marieblasi/wro2024-robotek/models/parts/gear.jpeg

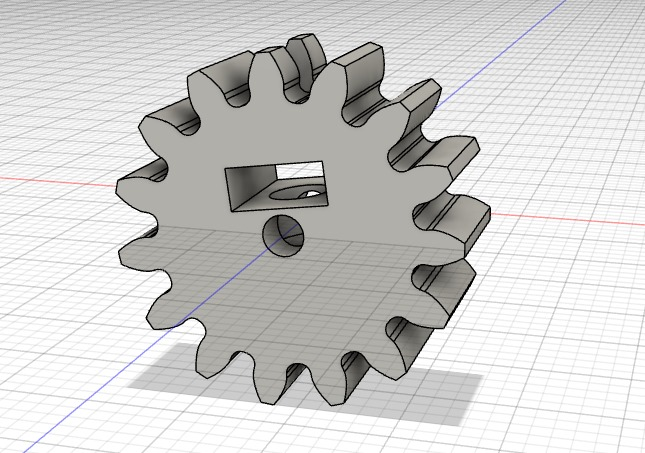
models/parts/gear.jpeg
