marieblasi/wro2024-robotek/models/parts/gear2.jpeg

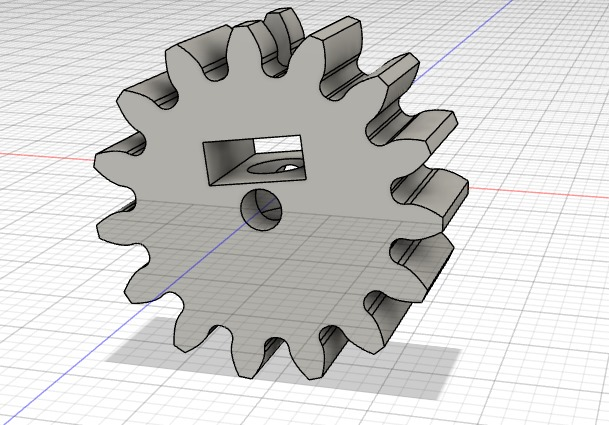
models/parts/gear2.jpeg
