marieblasi/wro2024-robotek/models/README.md

__3D-Printed Models__
====
An important factor in our project was the creation of 3D-printed models specifically designed to securely hold sensors and mechanical parts in place. These custom designs provided precise alignment and reduced potential obstructions. Furthermore, we employed 3D printing to fabricate durable yet lightweight structural elements, enabling us to customize the vehicle's design to meet our requirements without compromising on strength or flexibility.

In the [assemblies](assemblies) folder, there are the images of some systems.
In the [parts](parts) folder, there are images of all the parts we used for the car.
