marieblasi/wro2024-robotek/schemes/README.md

Electromechanical diagrams
====
Our full schematic diagram  to map meticulously the integration of every single component, the electromagnetic elements included. This diagram enssures precise conexions and fluid interactions between the circuits and the electromagnetic devices, like engines and sensors. Also, our flowdiagram is added to provide extra information related to our solution for the challenge.
