marieblasi/wro2024-robotek/models/back_3d.jpeg

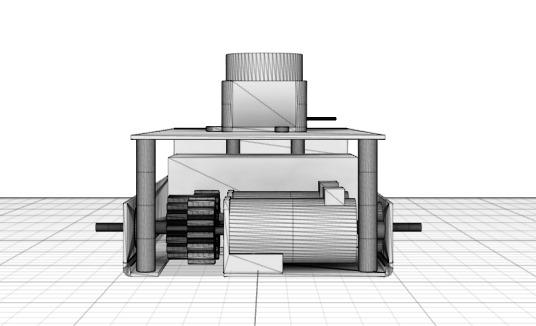
models/back_3d.jpeg
