marieblasi/wro2024-robotek/models/bottom_3d.jpeg

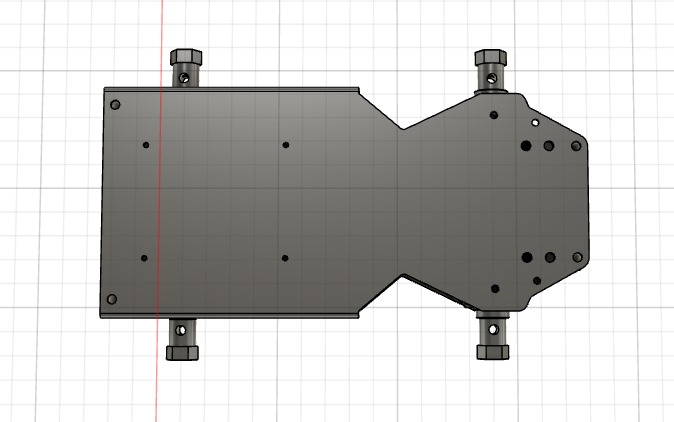
models/bottom_3d.jpeg
