marieblasi/wro2024-robotek/models/front_3d.jpeg

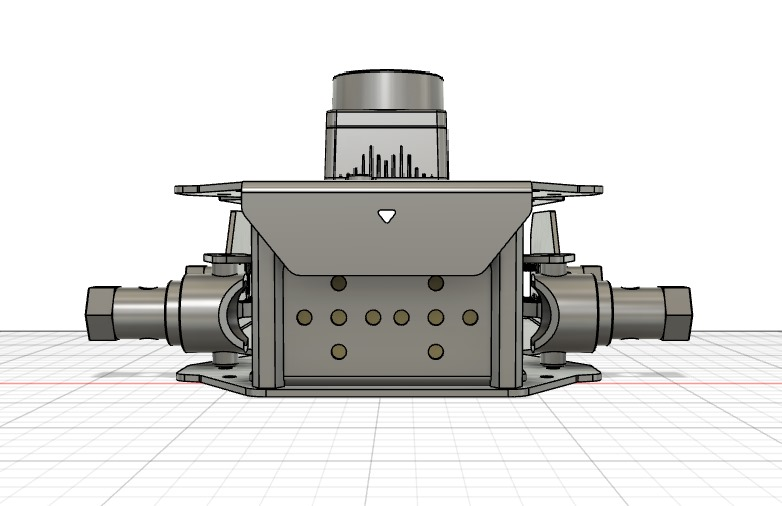
models/front_3d.jpeg
