marieblasi/wro2024-robotek/models/left_3d.jpeg

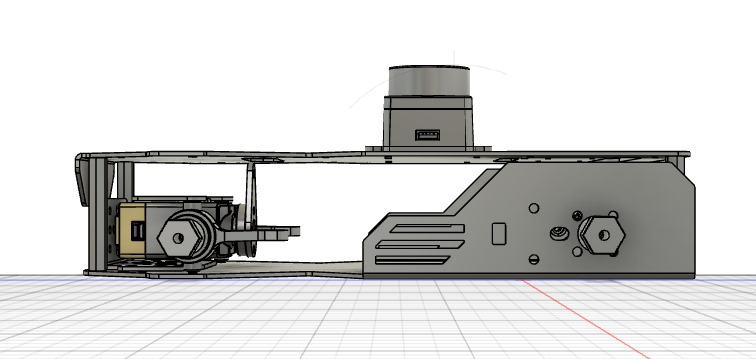
models/left_3d.jpeg
