marieblasi/wro2024-robotek/models/right_3d.jpeg

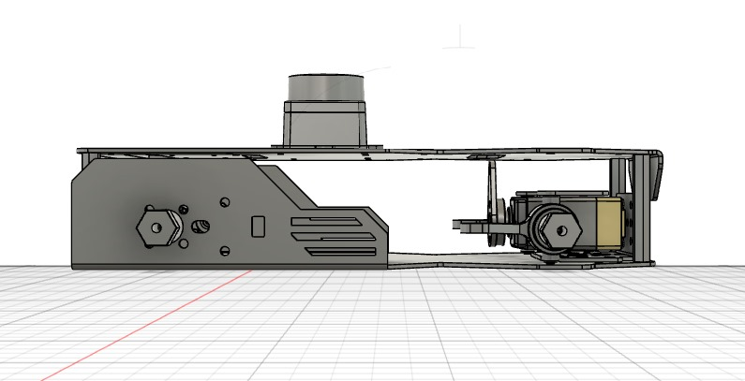
models/right_3d.jpeg
