marieblasi/wro2024-robotek/models/top_3d.jpeg

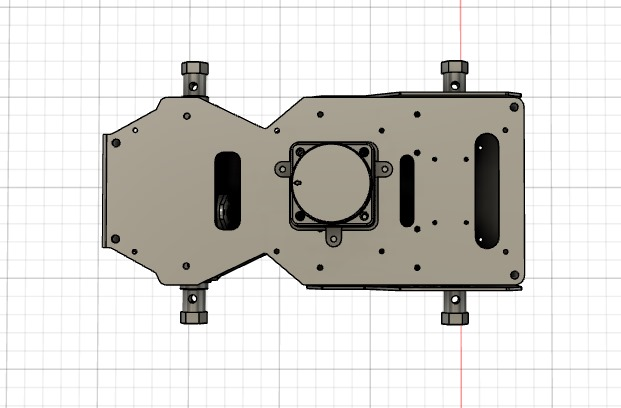
models/top_3d.jpeg
