marieblasi/wro2024-robotek/schemes/flow_diagram_obstacle_challenge.jpeg

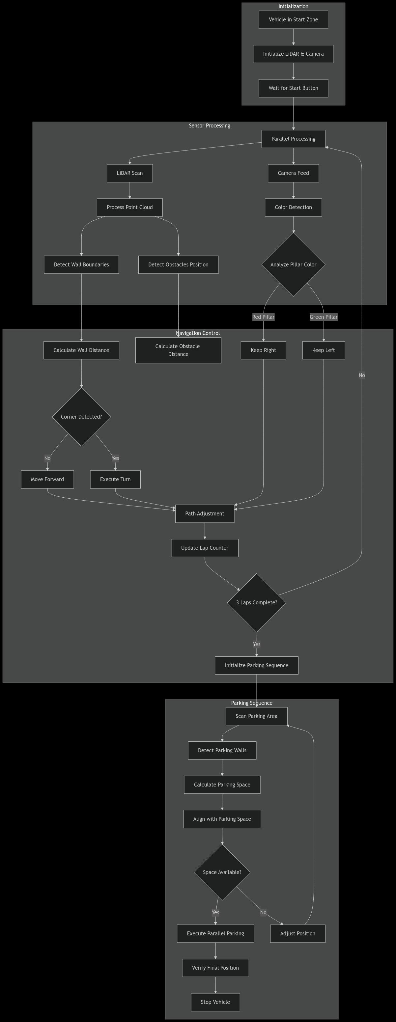
schemes/flow_diagram_obstacle_challenge.jpeg
