marieblasi/wro2024-robotek/schemes/flow_diagram_open_challenge.jpeg

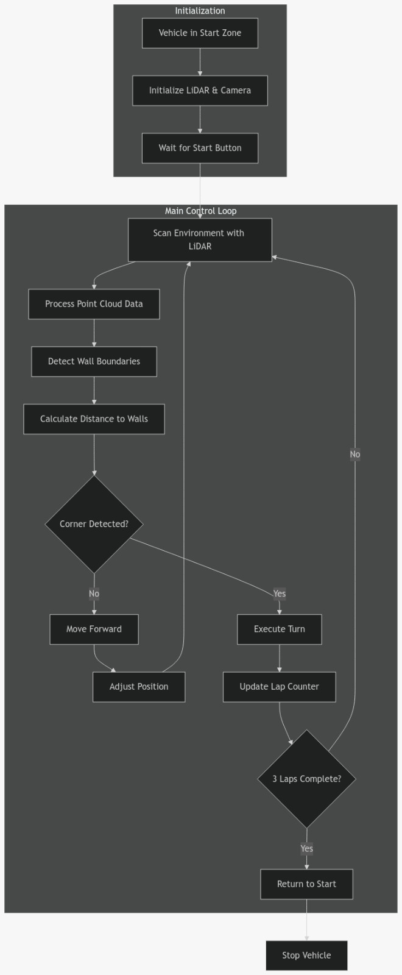
schemes/flow_diagram_open_challenge.jpeg
