marieblasi/wro2024-robotek/t-photos/funny photo.jpg

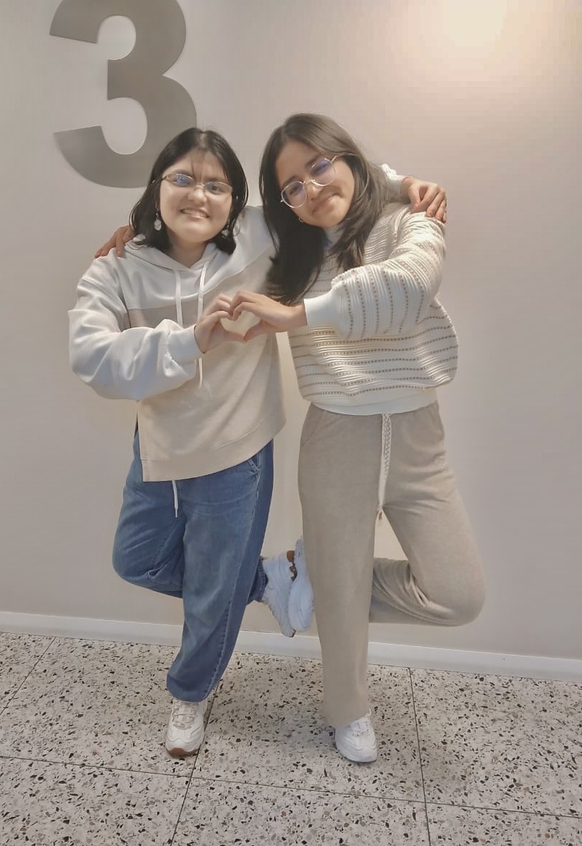
t-photos/funny photo.jpg
