marieblasi/wro2024-robotek/t-photos/official photo.jpg

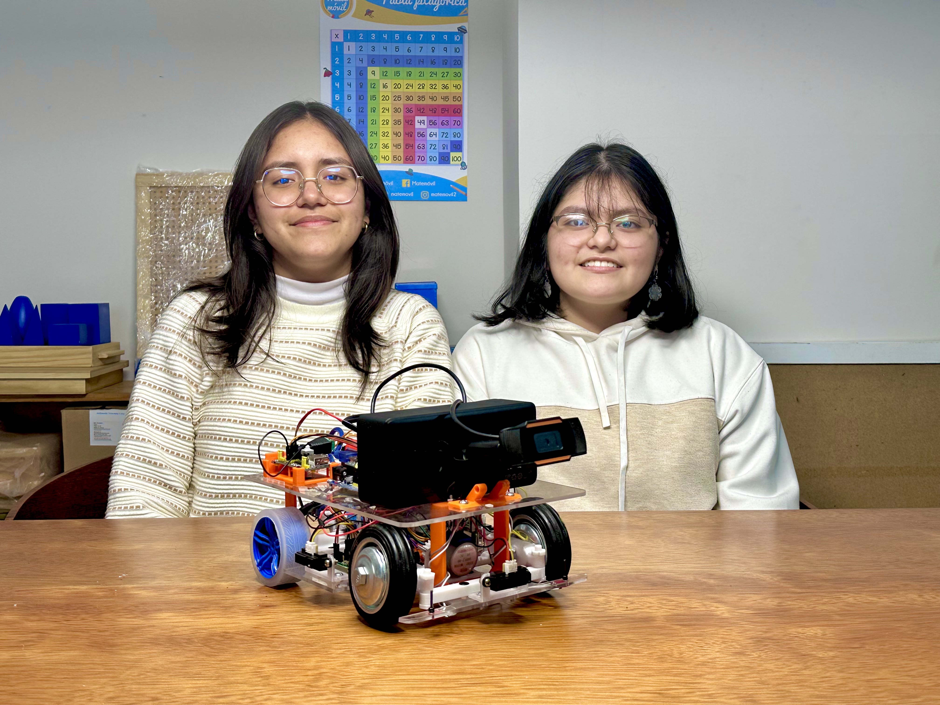
t-photos/official photo.jpg
