marieblasi/wro2024-robotek/t-photos/team's photo.jpg

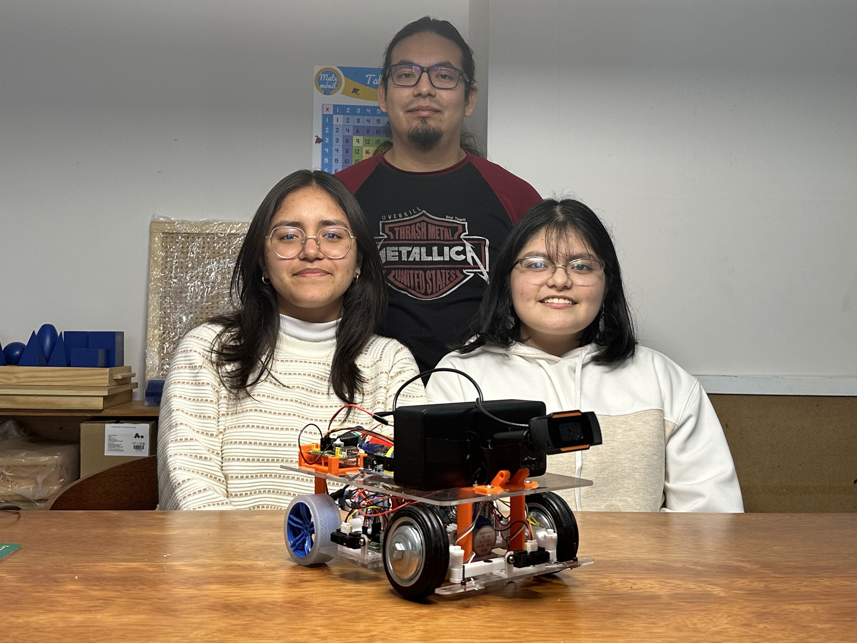
t-photos/team's photo.jpg
