marieblasi/wro2024-robotek/v-photos/back_final.jpeg

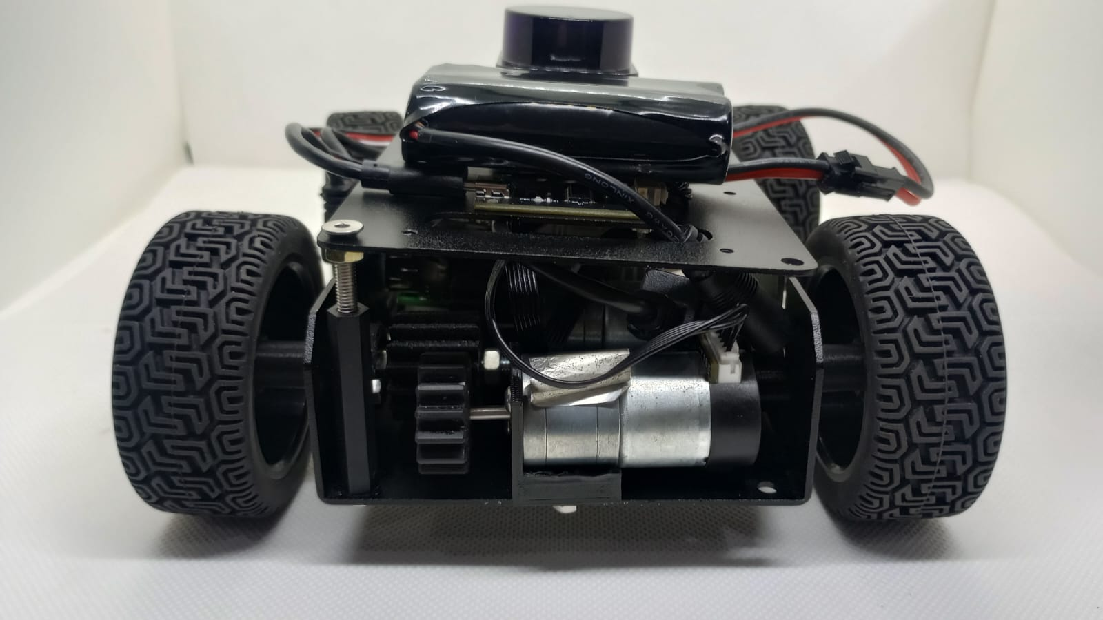
v-photos/back_final.jpeg
