marieblasi/wro2024-robotek/v-photos/bottom_final.jpeg

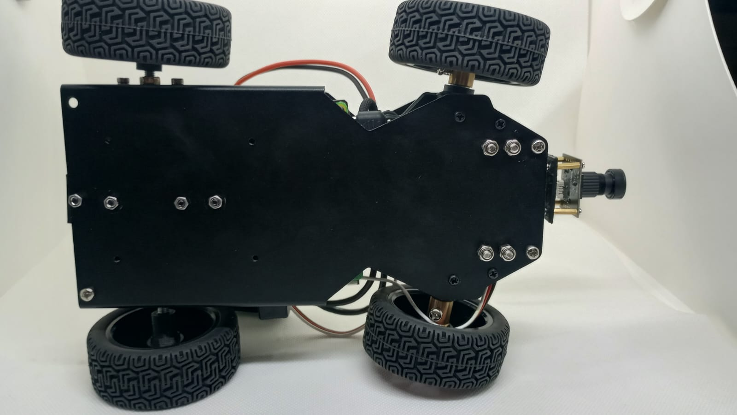
v-photos/bottom_final.jpeg
