marieblasi/wro2024-robotek/v-photos/front_final.jpeg

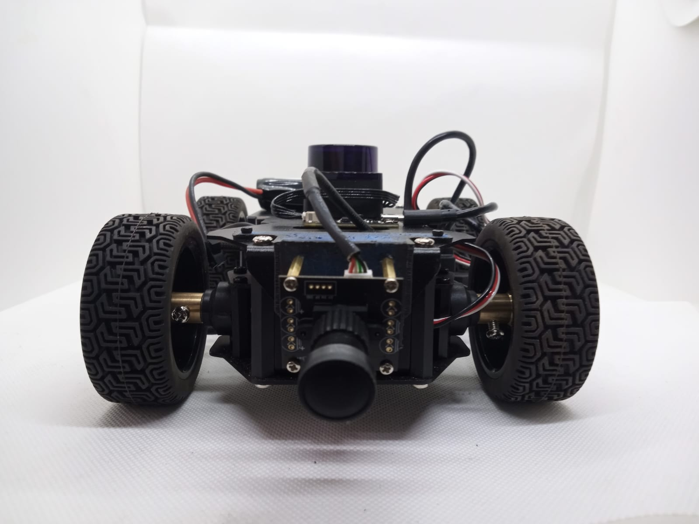
v-photos/front_final.jpeg
