marieblasi/wro2024-robotek/v-photos/left_final.jpeg

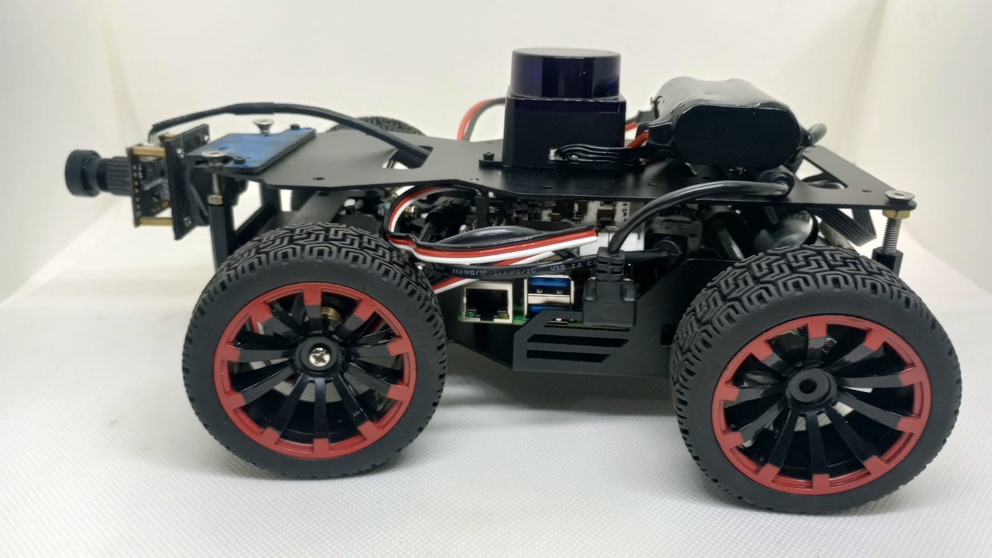
v-photos/left_final.jpeg
