marieblasi/wro2024-robotek/v-photos/right_final.jpeg

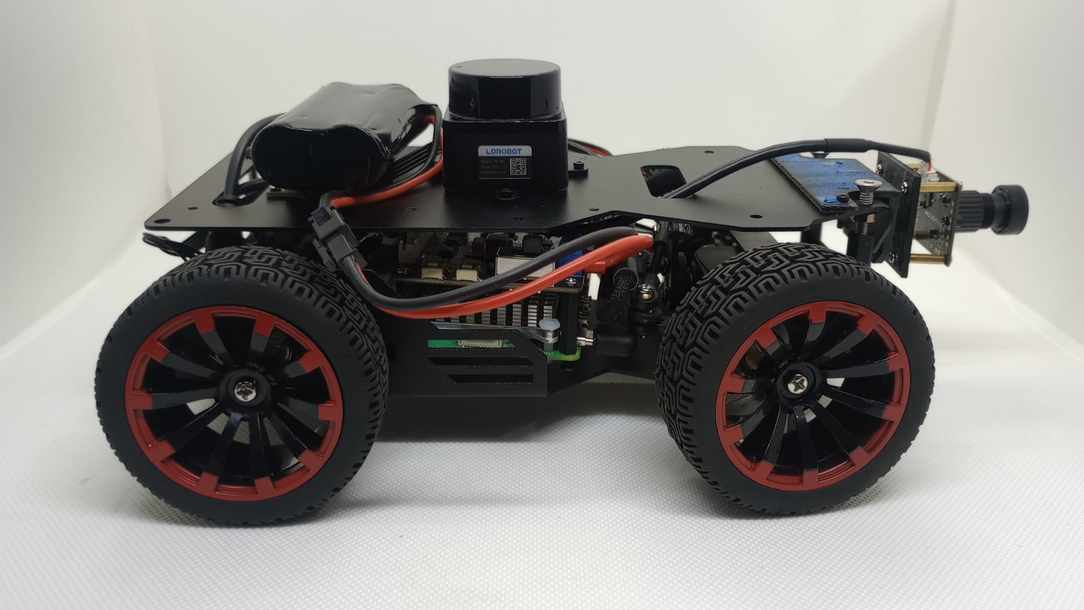
v-photos/right_final.jpeg
