marieblasi/wro2024-robotek/v-photos/top_final.jpeg

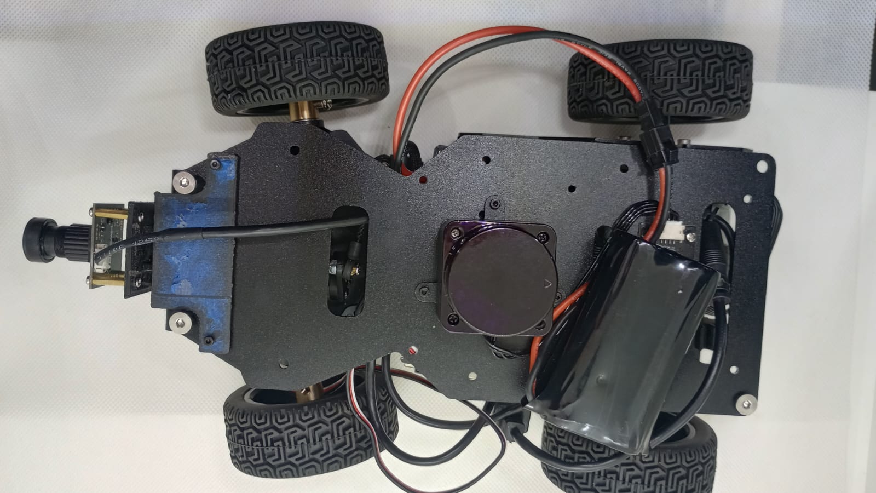
v-photos/top_final.jpeg
