marieblasi/wro2024-robotek/models/parts/axle.jpeg

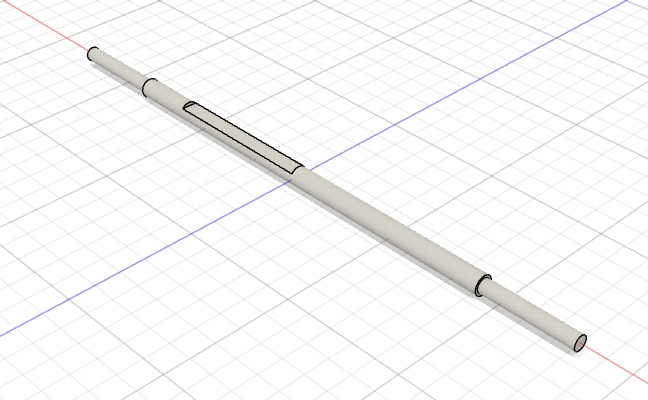
models/parts/axle.jpeg
