marieblasi/wro2024-robotek/models/parts/axle_gear.jpeg

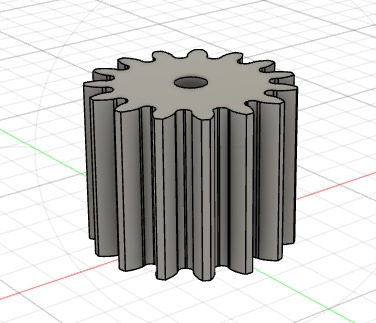
models/parts/axle_gear.jpeg
