marieblasi/wro2024-robotek/models/parts/base.jpeg

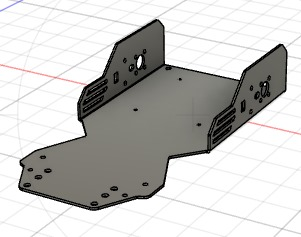
models/parts/base.jpeg
