marieblasi/wro2024-robotek/models/parts/motor_housing.jpeg

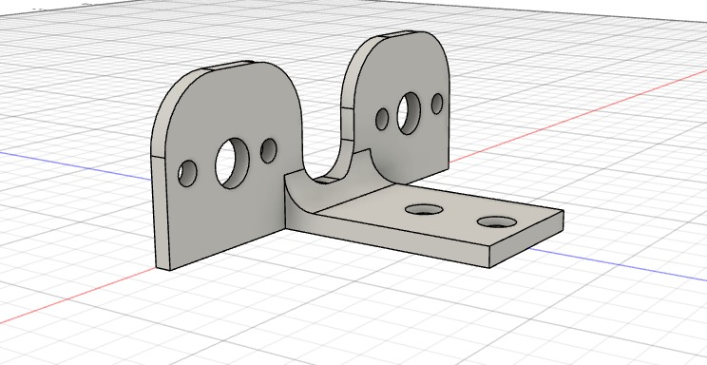
models/parts/motor_housing.jpeg
