marieblasi/wro2024-robotek/models/parts/upper_casing.jpeg

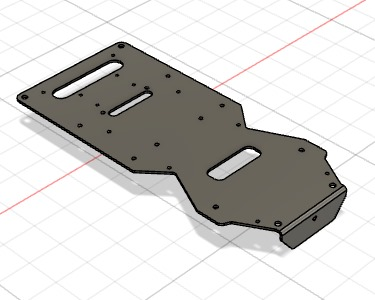
models/parts/upper_casing.jpeg
