marieblasi/wro2024-robotek/models/eje trasero.obj

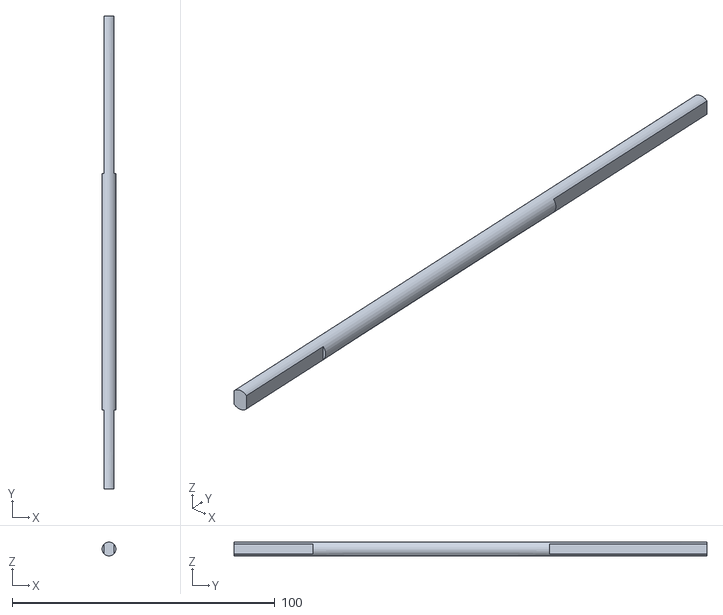
[picture p25: CAD file, 2024-08-25, last stored version]
models/eje trasero.obj
5.30 x 180.0 x 5.30
