marieblasi/wro2024-robotek/models/parts/soporte motor.obj

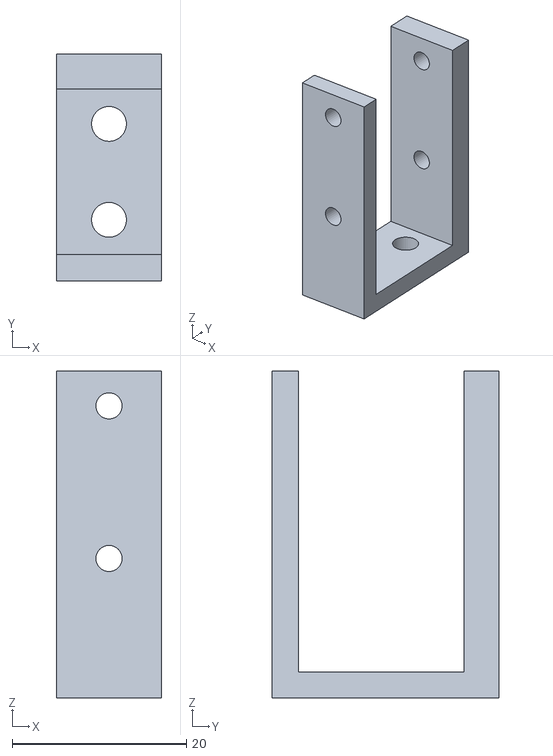
[picture p26: CAD file, 2024-08-25, last stored version]
models/parts/soporte motor.obj
12.0 x 26.0 x 37.5
