marieblasi/wro2024-robotek/models/gear rack.obj

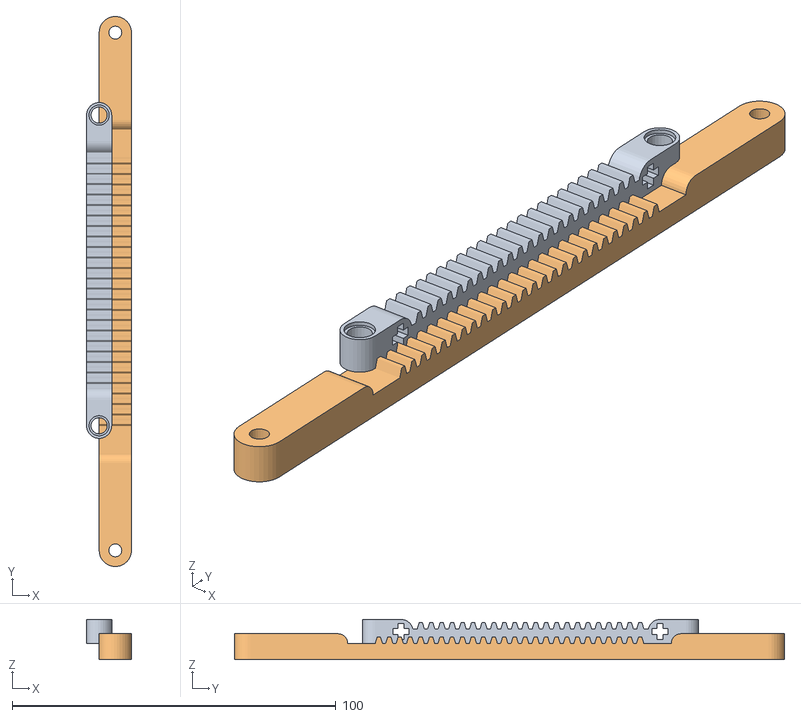
[picture p27: CAD file, 2024-08-25, last stored version]
models/gear rack.obj
13.9 x 170.0 x 12.4
