marieblasi/wro2024-robotek/models/parts/stepper gear v2.obj

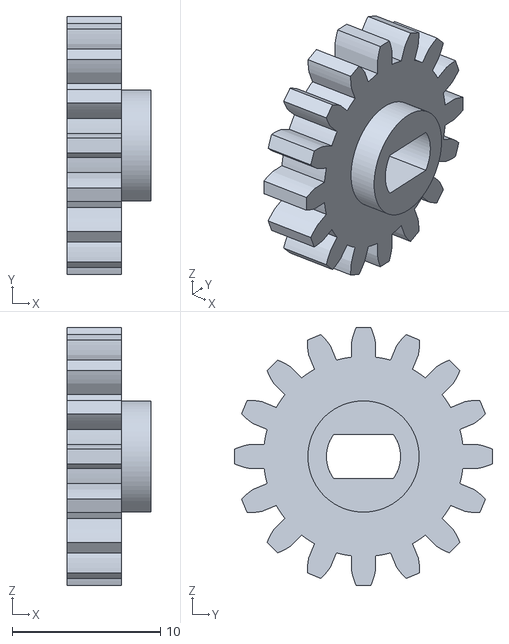
[picture p28: CAD file, 2024-08-25, last stored version]
models/parts/stepper gear v2.obj
5.70 x 17.4 x 17.4
