marieblasi/wro2024-robotek/models/base.obj

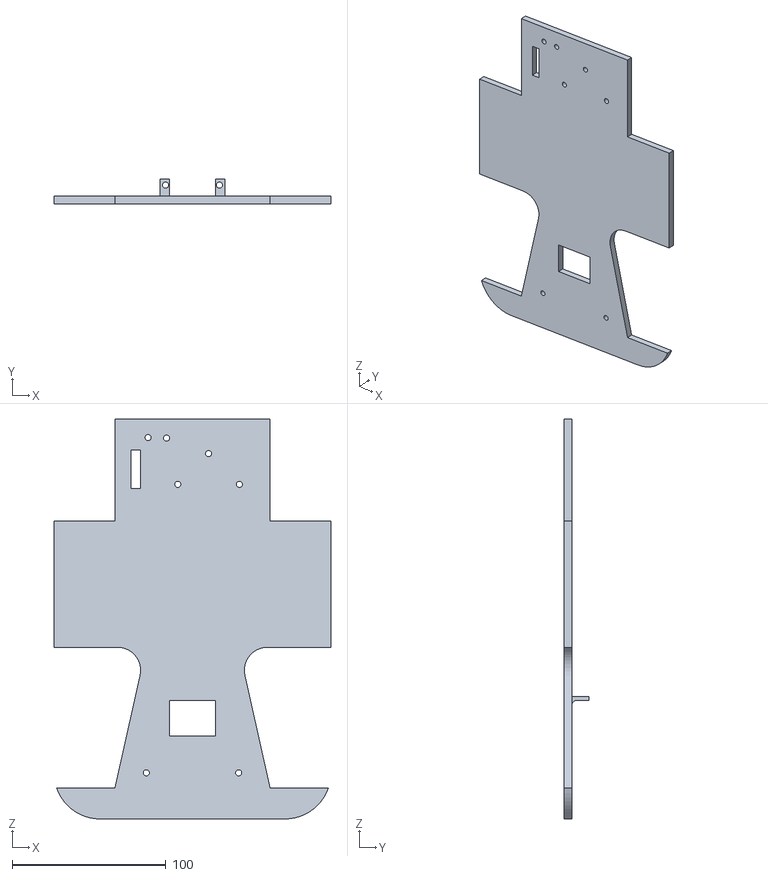
[picture p29: CAD file, 2024-08-25, last stored version]
models/base.obj
180.0 x 16.0 x 260.0
