marieblasi/wro2024-robotek/models/parts/rigido.obj

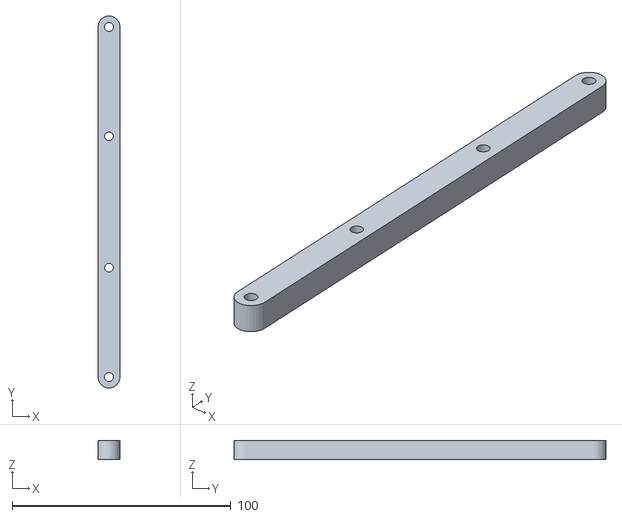
[picture p30: CAD file, 2024-08-25, last stored version]
models/parts/rigido.obj
10.0 x 170.0 x 8.80
