marieblasi/wro2024-robotek/models/eje delantero.obj

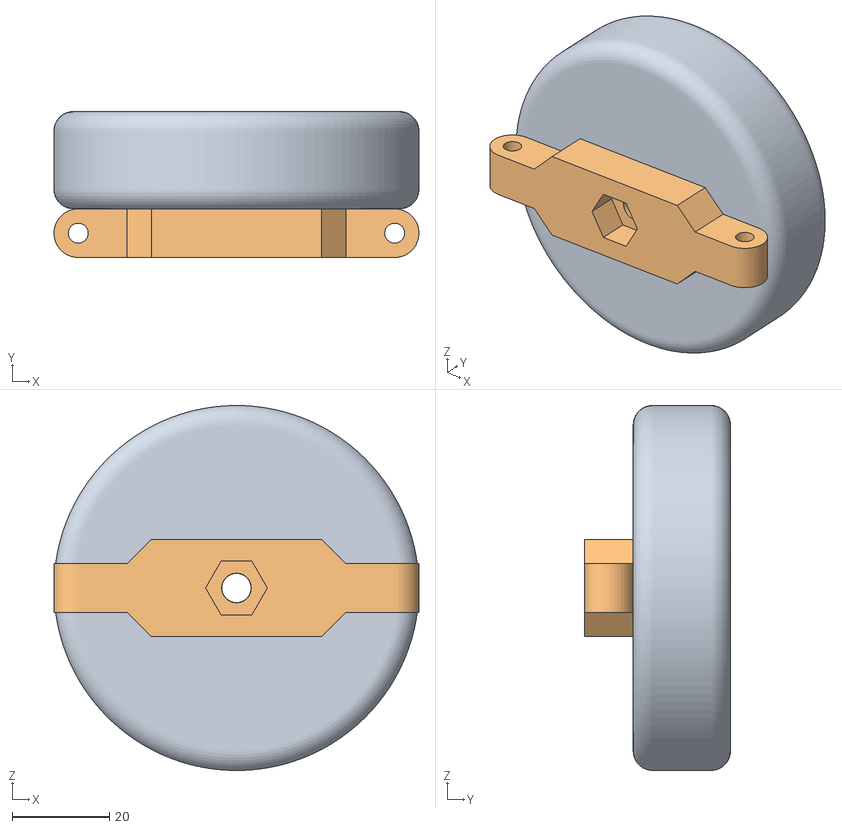
[picture p31: CAD file, 2024-08-25, last stored version]
models/eje delantero.obj
75.0 x 30.0 x 75.0
