marieblasi/wro2024-robotek/models/parts/stepper gear.obj

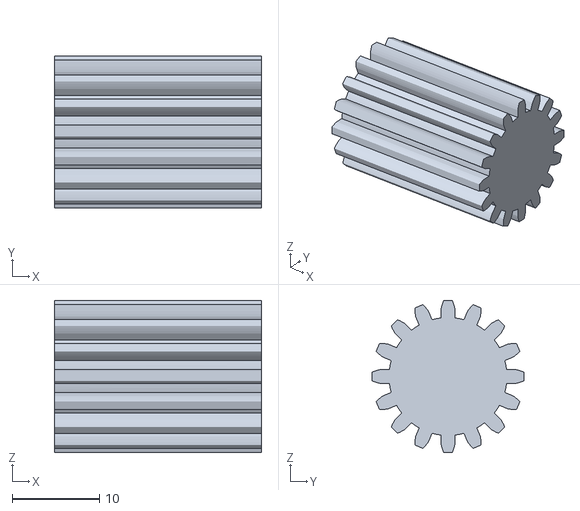
[picture p32: CAD file, 2024-08-25, last stored version]
models/parts/stepper gear.obj
23.7 x 17.4 x 17.4
