marieblasi/wro2024-robotek/models/parts/soporte eje.obj

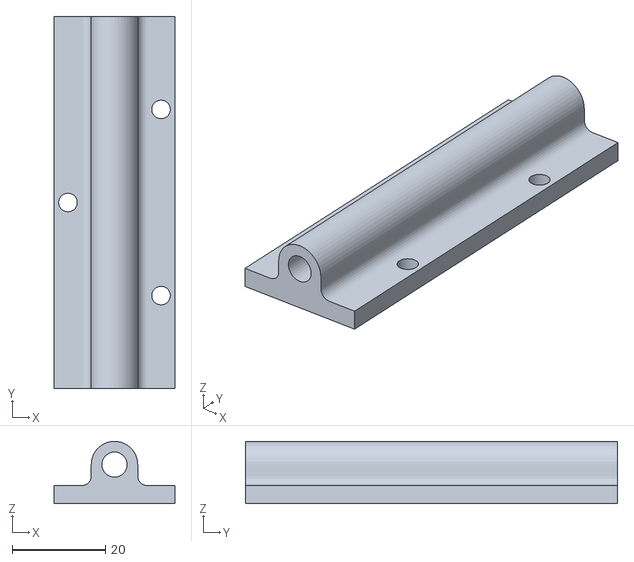
[picture p33: CAD file, 2024-08-25, last stored version]
models/parts/soporte eje.obj
26.0 x 80.0 x 13.4
