marieblasi/wro2024-robotek/models/assemblies/ackermann system.jpeg

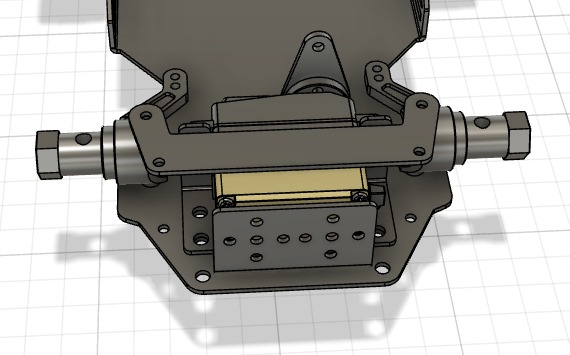
models/assemblies/ackermann system.jpeg
