marieblasi/wro2024-robotek/models/assemblies/gear_system.jpeg

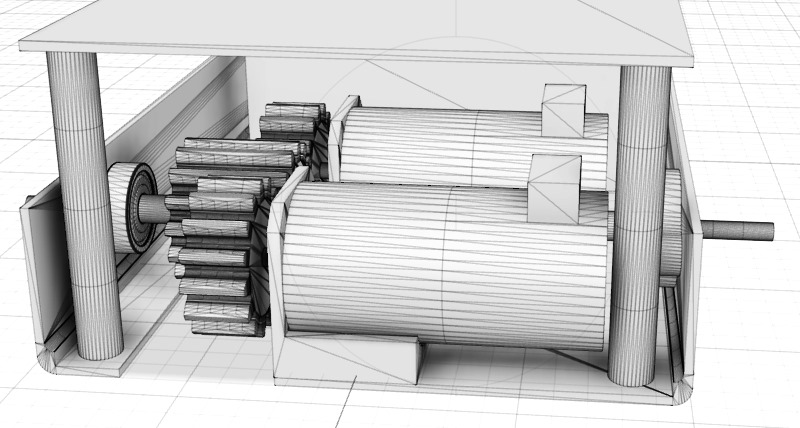
models/assemblies/gear_system.jpeg
