marieblasi/wro2024-robotek/schemes/wiring_diagram.jpeg

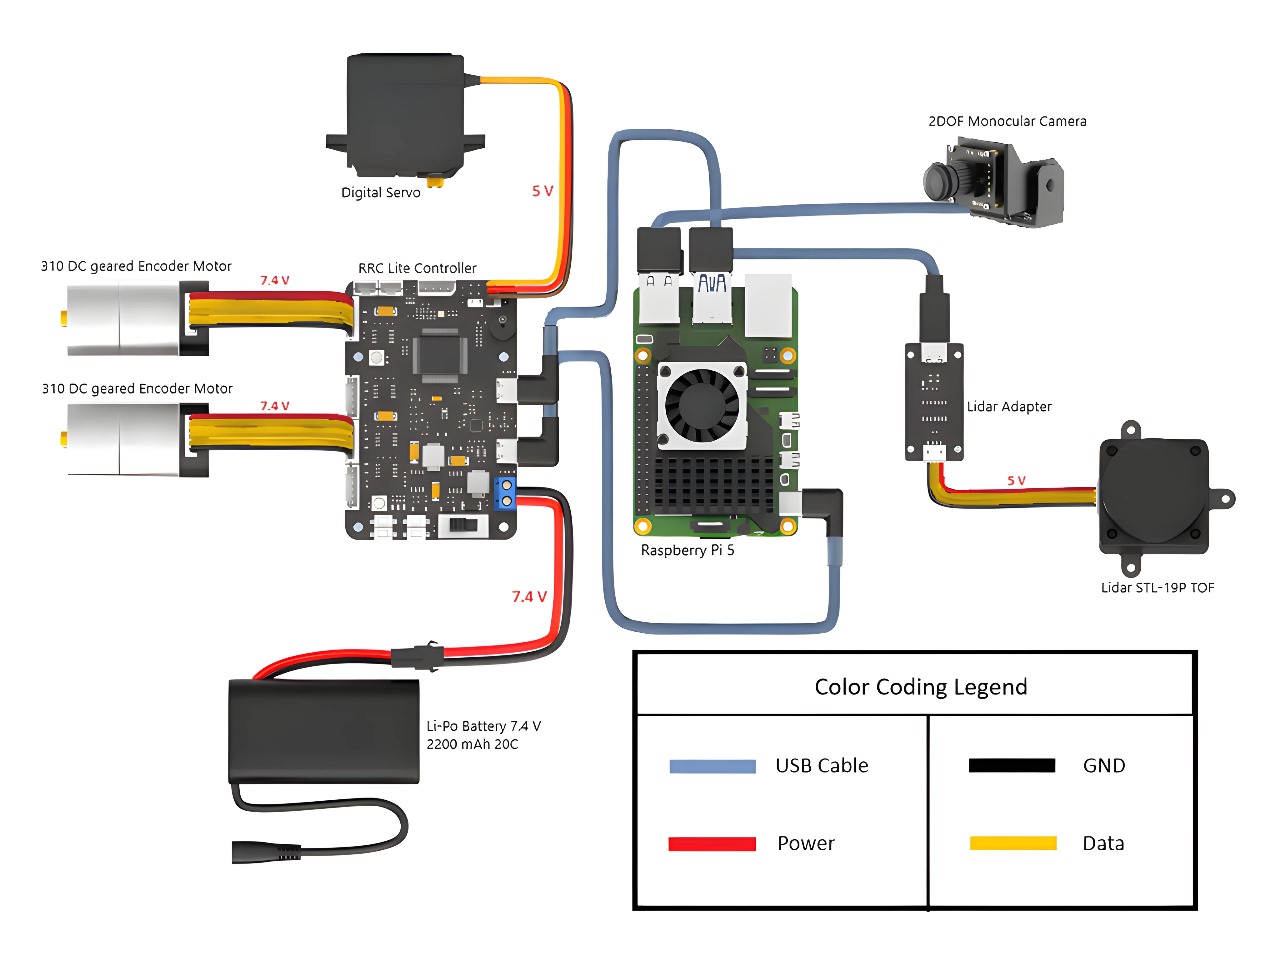
schemes/wiring_diagram.jpeg
