marieblasi/wro2024-robotek/(commit log)

2024-07-07 add prototype photos
2024-08-09 Add IR sensors setup and send the distance measurement to the rasperry pi through the serial port
2024-08-10 Add code to recieve the information from the serial port and print it
2024-08-10 Add motor control sequence with GPIO for DC and stepper motor
2024-08-10 Added a function to print the sensors data
2024-08-18 Added a code using forward and stop functions from motor.py
2024-08-20 Added motor control functions for forward, backward, stop, and rotation
2024-08-20 Added a serial communication function to read data from the sharp IR sensors
2024-08-25 add steering control based on side sensors
2024-08-25 add 3D-printed parts
    [base.obj, eje delantero.obj, eje trasero.obj, gear rack.obj, rigido.obj, soporte eje.obj, soporte motor.obj, stepper gear v2.obj]
2024-08-25 add PID logic function and steering rotation function (based on PID values) for turnings
2024-09-01 add limit to PID and let it read all the sensors
2024-09-01 added two extra IR sensors and we printed it
2024-09-01 created the 'parts' folder and added the 3D parts
    [base.obj, eje delantero.obj, eje trasero.obj, gear rack.obj, rigido.obj, soporte eje.obj, soporte motor.obj, stepper gear v2.obj]
2024-09-04 updated main motor in list of components
2024-09-05 sensor explanation and step 2 code
2024-09-06 step Arduino code completed
2024-09-06 step Camera code completed
2024-09-06 step Motors code completed
2024-09-06 updated step Raspberry pi4
2024-09-06 updated BOM
2024-09-06 added sensor to BOM
2024-09-06 added flowdiagram
2024-09-06 included flowdiagram
2024-09-06 completed the BOM frame
2024-09-07 added wiring diagram
2024-09-07 creted the "assemblies" forlder with photos
2024-09-07 updated wiring diagram
2024-09-07 added the final prototype step
2024-09-08 updated final code for motors
2024-11-01 updated for the new prototype
2024-11-01 added the final prototype
2024-11-01 updated why sensors step
2024-11-01 updated BOM section
2024-11-10 added power sources.md
2024-11-12 submitted flow diagrams
2024-11-12 changed the flow diagram
2024-11-12 added the car's assemblies
2024-11-12 finished with the assembly instructions
2024-11-13 added camera codes
